yquemener/ArmStone/hardware/readme.md

## CAD
CAD files for Armstone robot are hosted on OnShape:
https://cad.onshape.com/documents/b477500cbd234898a8460865/w/df28597f68172f26d1d1cff9/e/52443cd5e5fe507c833839db

## Procedures
### Charge Battery
* Turn off the battery
* Un plug battery from the system
* Turn on the battery
* plug in the charger
 
### Turn off the DC control box
* Control box is turned off by holding a little power button on the box for 5 seconds or so (not the power switch on armstone dashboard)

### Power from PSU
WARNING: Please unplug the battery(center of the robot. The big black connector) from the system before plugging in the PSU.
There is a 48V PSU that comes with the system. To the left of the battery there is a connector labeled `System Raw In` You can switch out PSU and battery power from there.
