yquemener/ArmStone/hardware/BoM Armstone.ods

nameFR | name | specFR | spec | vendorURLs | filepath | quantity | qty extra | unit price | total price incl delivery
plaque de support frontale |  | plaque alu 8mm découpée à la CNC plasma |  |  | hardware/STL/cut_metal/parts - MountingPlate.stl | 1
plaque de support inférieure |  | plaque plsatique 3mm (acetal?) découpée à la laser |  |  | hardware/STL/cut_plastic/Acetal - underbelly plate.stl | 1
plaque de support latérale |  | plaque plsatique 3mm (acetal?) découpée à la laser |  |  | hardware/STL/cut_plastic/Acetal\ -\ sidebelly.stl | 2
plaque de support PC |  | plaque plsatique 3mm (acetal?) découpée à la laser |  |  | hardware/STL/cut_plastic/Acetal – nucholder.stl | 2
Plaque alu |  | 455x200x8mm |  | https://www.dold-mechatronik.de/Plaques-en-aluminium-EN-AW-5083-Alu-non-revetues-Epaisseur-8mm-Largeur-200mm-432kg-m-Recadrage-20-3000mm |  | 1 | €1.00 | €37.55 | €265.72
profilé V-slot 40x20 | L1 | €680.00 |  | https://www.dold-mechatronik.de/Profile-en-aluminium-noir-20x40L-I-Type-avec-rainure-5-088kg-m-decoupe-de-50-a-6000mm |  | 2 |  | €7.13 |  | €1,360.00
profilé V-slot 40x20 | L2 | €470.00 |  | https://www.dold-mechatronik.de/Profile-en-aluminium-noir-20x40L-I-Type-avec-rainure-5-088kg-m-decoupe-de-50-a-6000mm |  | 2 |  | €5.05
profilé V-slot 20x20 | L3 | €230.00 |  | https://www.dold-mechatronik.de/Profile-en-aluminium-noir-20x20L-I-Type-avec-rainure-5-049kg-m-decoupe-de-50-a-6000mm |  | 1 |  | €1.76 |  | €230.00
profilé V-slot 20x20 | T1 | €455.00 |  | https://www.dold-mechatronik.de/Profile-en-aluminium-noir-20x20L-I-Type-avec-rainure-5-049kg-m-decoupe-de-50-a-6000mm |  | 2 |  | €3.01 |  | €910.00
profilé V-slot 20x20 | T2 | €375.00 |  | https://www.dold-mechatronik.de/Profile-en-aluminium-noir-20x20L-I-Type-avec-rainure-5-049kg-m-decoupe-de-50-a-6000mm |  | 5 |  | €2.51 |  | €1,875.00
profilé V-slot 20x20 | H1 | €130.00 |  | https://www.dold-mechatronik.de/Profile-en-aluminium-noir-20x20L-I-Type-avec-rainure-5-049kg-m-decoupe-de-50-a-6000mm |  | 6 |  | €1.12 |  | €780.00
profilé V-slot 20x20 | D1 | €208.10 |  | https://www.dold-mechatronik.de/Profile-en-aluminium-noir-20x20L-I-Type-avec-rainure-5-049kg-m-decoupe-de-50-a-6000mm |  | 2 |  | €1.59 |  | €416.20 | longueur totale | €5,571.20
profilé V-slot 40x20 | rab2 | €800.00 |  |  |  | 10 |  | €4.87
profilé V-slot 20x20 | rab1 | €1,500.00 |  |  |  | 2 |  | €15.25
Connecteur plaque 78-L, 12 trous |  |  |  | https://www.dold-mechatronik.de/Connecteur-plaque-78-L-12-trous-decoupe-au-laser-decoupe |  | 4 |  | €2.10
Plaque de connecteur type I rainure 5 |  |  |  | https://www.dold-mechatronik.de/Plaque-de-connecteur-type-I-rainure-5-LD-20x80x80mm-acier-2mm-galvanise |  | 4 |  | €2.03
Plaque de connexion T |  |  |  | https://www.dold-mechatronik.de/Plaque-de-connexion-2020-aluminium-anodise-rainure-de-type-I-5-rainure-de-type-B-6 |  | 10 |  | €1.47
Charnière 20x20 rainure de type I lumière 5 incl. Kit de montage |  |  |  | https://www.dold-mechatronik.de/Charniere-20x20-rainure-de-type-I-lumiere-5-incl-Kit-de-montage |  | 2 |  | €3.82
Equerre 20 + set fix |  |  |  | https://www.dold-mechatronik.de/Angle-20-rainure-de-type-I-5-incl-Set-de-fixation |  | 16 |  | €1.54
Noix M4 |  |  |  | https://www.dold-mechatronik.de/Dispositif-coulissant-M4-avec-rainure-I-type-de-bande-5 |  | 50 |  | €0.28
Noix M3 |  |  |  | https://www.dold-mechatronik.de/Dispositif-coulissant-M3-avec-rainure-I-type-de-bande-5 |  | 50 |  | €0.28
boite de vis M3 12mm |  |  |  | https://www.dold-mechatronik.de/DIN-7984-Vis-a-tete-cylindrique-a-six-pans-creux-et-basse-pression-en-acier-inoxydable-A2-M3X12 |  | 100 |  | €0.08
boite de vis M3 8mm |  |  |  | https://www.dold-mechatronik.de/DIN-7984-Vis-a-tete-cylindrique-a-six-pans-creux-et-basse-pression-en-acier-inoxydable-A2-M3X8 |  | 100 |  | €0.08
boite de vis M4 12mm |  |  |  | https://www.dold-mechatronik.de/DIN-7984-Vis-a-tete-cylindrique-a-six-pans-creux-et-basse-pression-en-acier-inoxydable-A2-M3X8 |  | 100 |  | €0.08
fils 2.5 mm 5m |  | rouge, noir, bleu, vert, jaune |  | https://fr.aliexpress.com/item/1005002915535178.html?mp=1 |  | 5 |  | €6.89 | €1,173.18
charnière pour tube 20x20 |  |  |  | https://fr.aliexpress.com/item/1005005885593483.html?scm_id=1007.40000.327270.0&scm-url=1007.40000.327270.0 |  | 4 | €2.00 | €2.86
Connecteurs |  | lot de 5 |  | https://fr.aliexpress.com/item/1005006393566221.html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 |  | 2 |  | €2.31
Ensemble de 4 roues mecanum+moteur |  |  |  | https://fr.aliexpress.com/item/4001034973724.html |  | 1 |  | €684.28
dominos 23A | 12 points 25A |  |  | https://fr.aliexpress.com/item/1005002678786621.html |  | 1
dominos 23A | 6 points 25A |  |  | https://fr.aliexpress.com/item/1005002678786621.html |  | 4
peignes pour domino 21A | 6 points |  |  | https://fr.aliexpress.com/item/10000406925039.html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 |  | 4
peignes pour domino 21A | 3 points |  |  | https://fr.aliexpress.com/item/10000406925039.html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 |  | 6
downconverter 24V | 36/48V → 24V 20A |  |  | https://fr.aliexpress.com/item/32383492278.html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 |  | 2 |  | €21.79
downconverter 12V | 48/60V → 12V 26A |  |  | https://fr.aliexpress.com/item/4000140092142.html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 |  | 1 |  | €31.79
IMU |  |  |  | https://fr.aliexpress.com/item/1005004200545523.html?gatewayAdapt=glo2fra |  | 1 |  | €48.49
Emergency stop button |  |  |  | https://fr.aliexpress.com/item/1005004110630812.html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 |  | 4 |  | €5.11
power button |  |  |  | https://fr.aliexpress.com/item/32800996847.html?mp=1 |  | 1 |  | €4.95
ebike battery | 48V 21A 20ah 1500W |  |  | https://www.amazon.fr/gp/product/B0CHJNTZKJ/ref=ox_sc_act_title_1?smid=A7DH4UBMIZC5D&psc=1 |  | 1 |  | €329.00 | €404.98
Charge display for 48V battery |  |  |  | https://www.amazon.com/Battery-DROK-Capacity-Fahrenheit-Indicator/dp/B085DKR34W |  | 1 |  | €11.98
Stabilisateur alim 12-40V pour PC |  |  |  | https://www.amazon.fr/gp/product/B08T12J8KL/ref=sw_img_1?smid=A1X7QLRQH87QA3&psc=1 |  | 2 |  | €10.55
wifi eth router |  |  |  | https://www.amazon.fr/GL-iNet-GL-SFT1200-Routeur-s%C3%A9curis%C3%A9-r%C3%A9p%C3%A9teur/dp/B09N72FMH5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 |  | 1 |  | €35.75
switchblox |  |  |  | https://coolcomponents.co.uk/products/switchblox-a-tiny-5-port-ethernet-switch-designed-for-robotics |  | 1 |  |  | €89.90
USH hub | 6 ports |  |  | https://www.ldlc.com/en/product/PB00253240.html |  | 2 |  |  | €1,061.28
cable USB | micro USB 50 cm |  |  | https://www.ldlc.com/en/product/PB00185199.html |  | 4
cable USB | mini USB 50 cm |  |  | https://www.ldlc.com/en/product/PB00265154.html |  | 2
NUC | spec différente |  |  | https://www.ldlc.com/fiche/PB00591674.html |  | 2
Controlleur moteur VESC | C'est cher! Mais bon, c'est un package... |  |  | https://maytech.cn/products/maytech-200a-vesc6-0-based-speed-controller-with-anti-spark-switch-for-electric-skateboard-mountainbaord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 |  | 4 |  | €230.80 | €255.54
PSU | 48V 20A 1000W (pas forcément nécessaire) |  |  |  |  | 1
