yquemener/ArmStone/hardware/STL/3dprint/12mmCoupler.stl

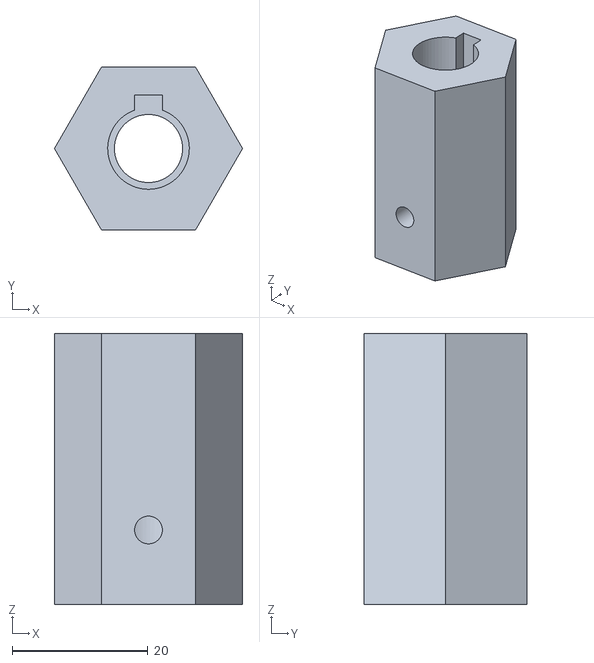
[picture p1: CAD file, 2024-03-12]
hardware/STL/3dprint/12mmCoupler.stl
27.8 x 24.0 x 40.0
