yquemener/ArmStone/hardware/STL/cut_plastic/Acetal - sidebelly.stl

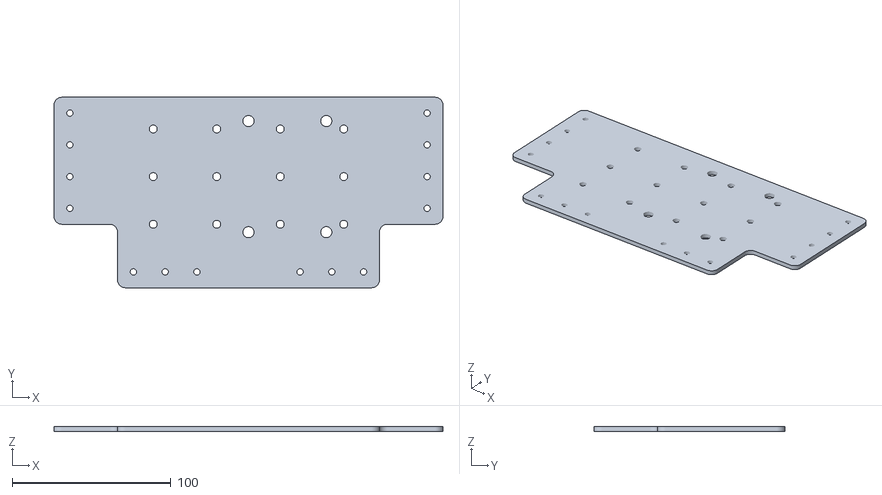
[picture p2: CAD file, 2024-03-12]
hardware/STL/cut_plastic/Acetal - sidebelly.stl
245.0 x 120.0 x 3.00
