yquemener/ArmStone/hardware/STL/3dprint/EStop Holder.stl

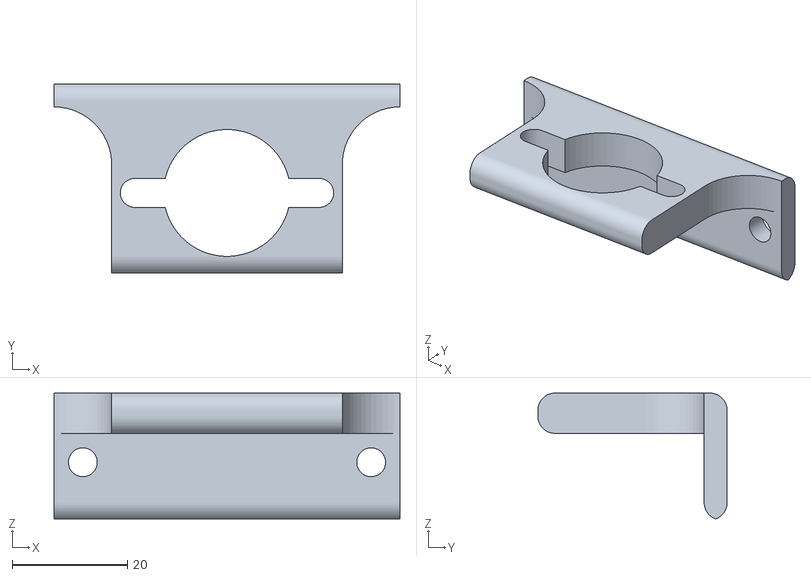
[picture p3: CAD file, 2024-03-12]
hardware/STL/3dprint/EStop Holder.stl
60.0 x 32.8 x 21.8
