yquemener/ArmStone/hardware/STL/cut_plastic/Acetal - nucholder.stl

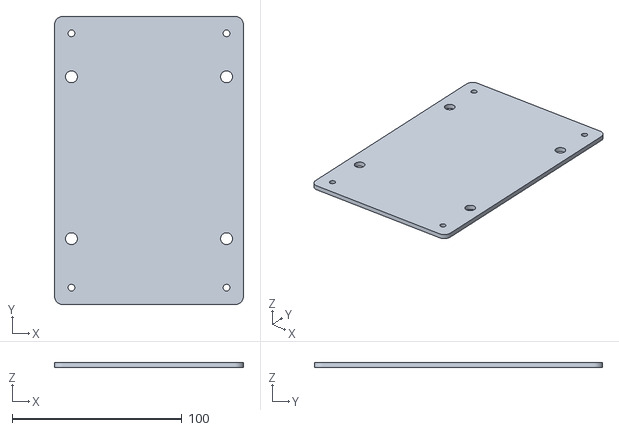
[picture p4: CAD file, 2024-03-12]
hardware/STL/cut_plastic/Acetal - nucholder.stl
111.5 x 170.0 x 3.00
