yquemener/ArmStone/hardware/STL/3dprint/HokuyoHolder.stl

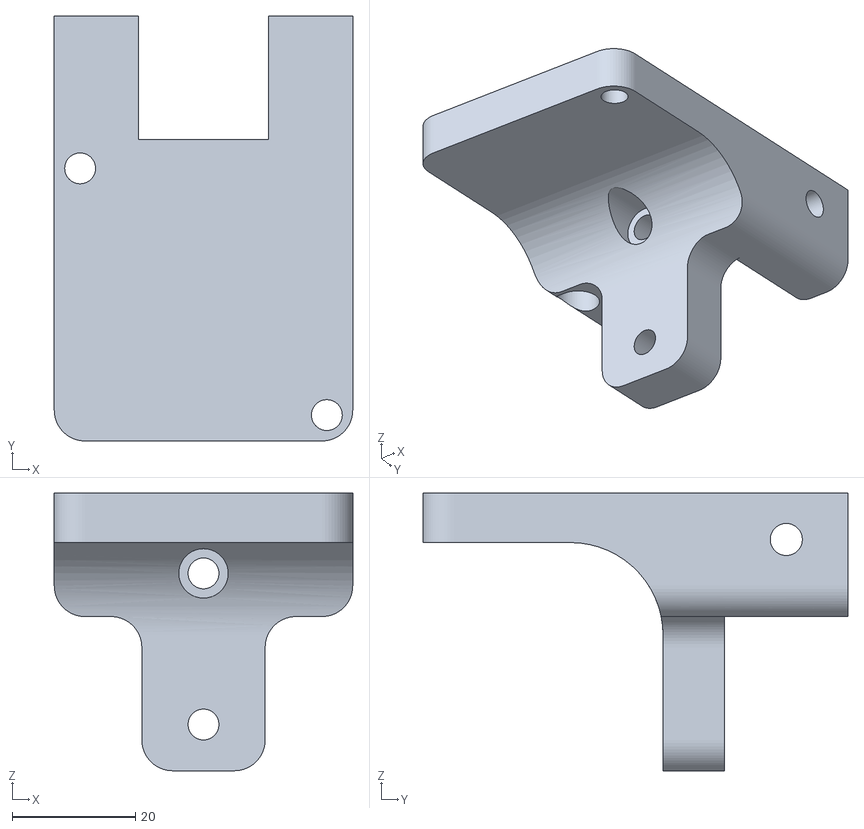
[picture p5: CAD file, 2024-03-12]
hardware/STL/3dprint/HokuyoHolder.stl
48.4 x 68.9 x 45.0
