yquemener/ArmStone/hardware/STL/cut_plastic/Acetal - underbelly plate.stl

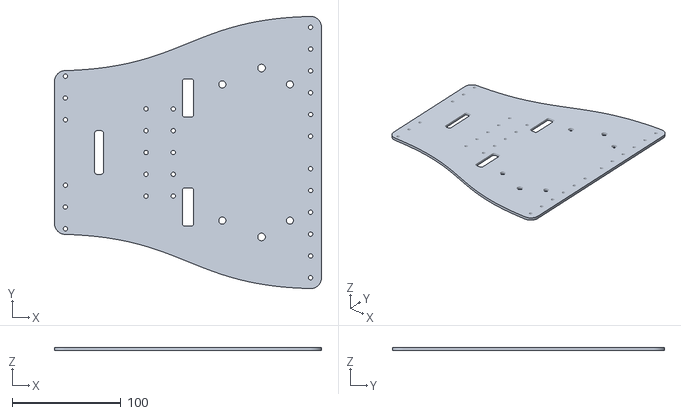
[picture p6: CAD file, 2024-03-12]
hardware/STL/cut_plastic/Acetal - underbelly plate.stl
245.0 x 249.8 x 3.00
