yquemener/ArmStone/hardware/STL/3dprint/double pillow.stl

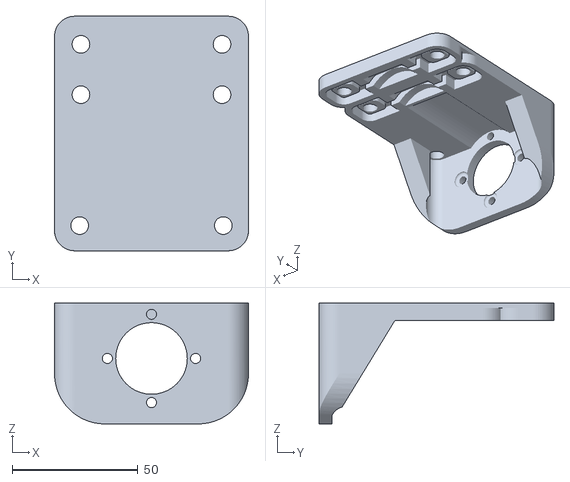
[picture p7: CAD file, 2024-03-12]
hardware/STL/3dprint/double pillow.stl
77.0 x 93.1 x 48.0
