yquemener/ArmStone/hardware/STL/3dprint/ArmStoneDashboard.stl

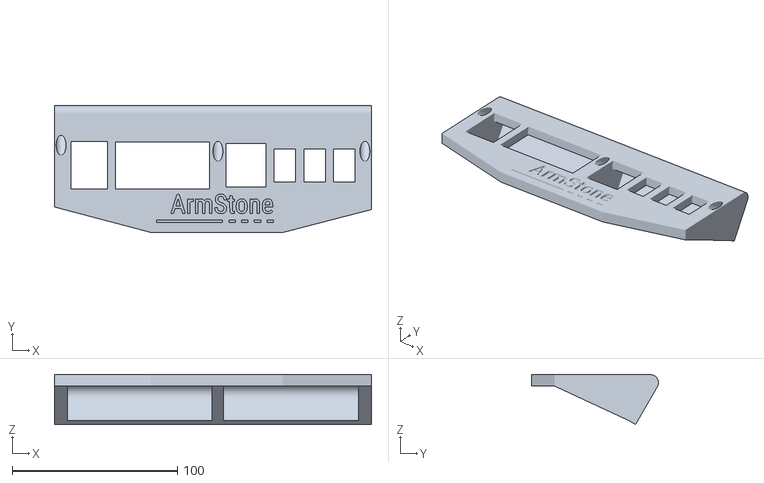
[picture p8: CAD file, 2024-03-12]
hardware/STL/3dprint/ArmStoneDashboard.stl
192.0 x 76.8 x 30.3
