yquemener/ArmStone/(commit log)

2024-03-12 Added a BoM, sorted the STL files, removed some added some to match the specs of the MUAL version of Armstone
    [12mmCoupler.stl, Acetal - nucholder.stl, Acetal - sidebelly.stl, Acetal - underbelly plate.stl, ArmStoneDashboard.stl, BoM Armstone.ods, EStop Holder.stl, EtruderBelly.stl]
2024-07-18 Added many files related to bichon and the claw
2024-07-19 Session avec Yves et Marceau Boucle de controle joy+asservissement+holonomics pour poupette
2024-07-22 Small modifications to the clamp arduino testing code
2024-07-30 Servoing with vision on orchestrator UI
